VuLinh011218/Auto_Switch/Hardware/02_Schematic_PDF/Smart_Switch.pdf

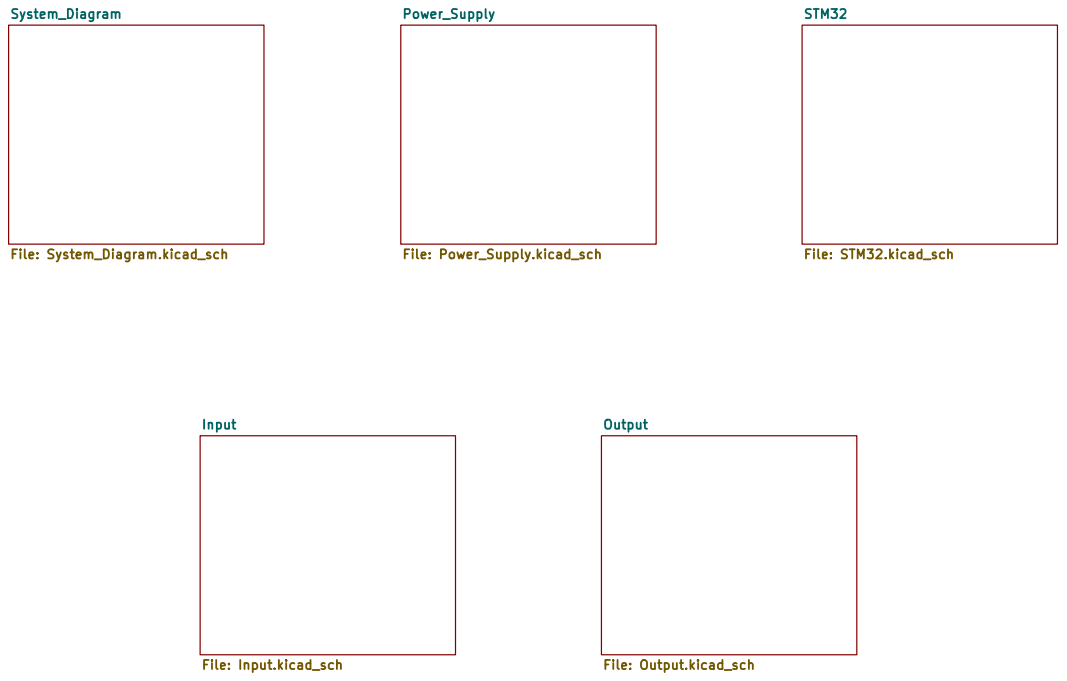
[picture p1: page 1]

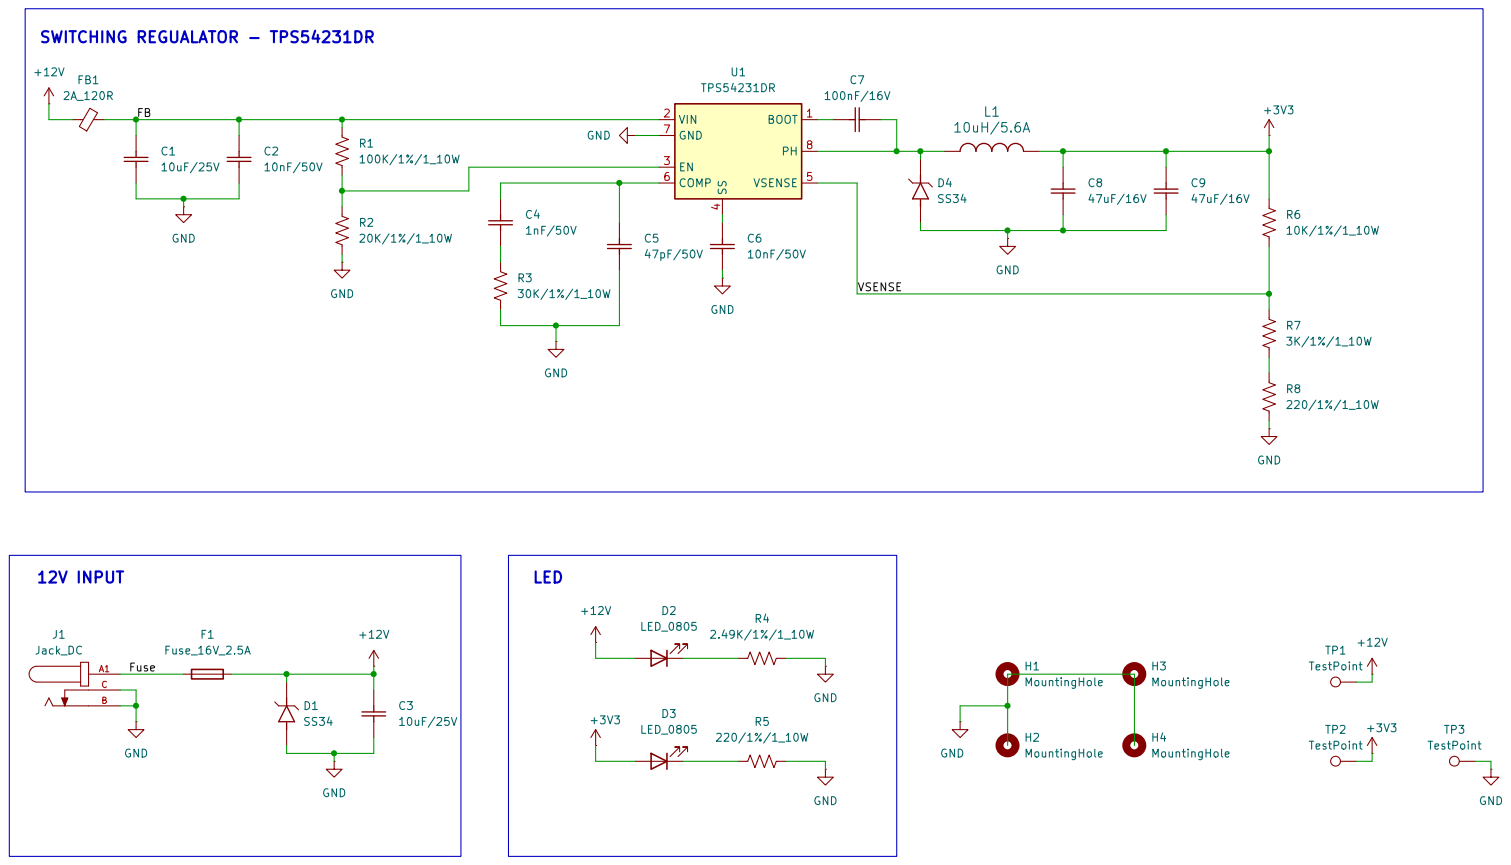
[picture p2: page 3]

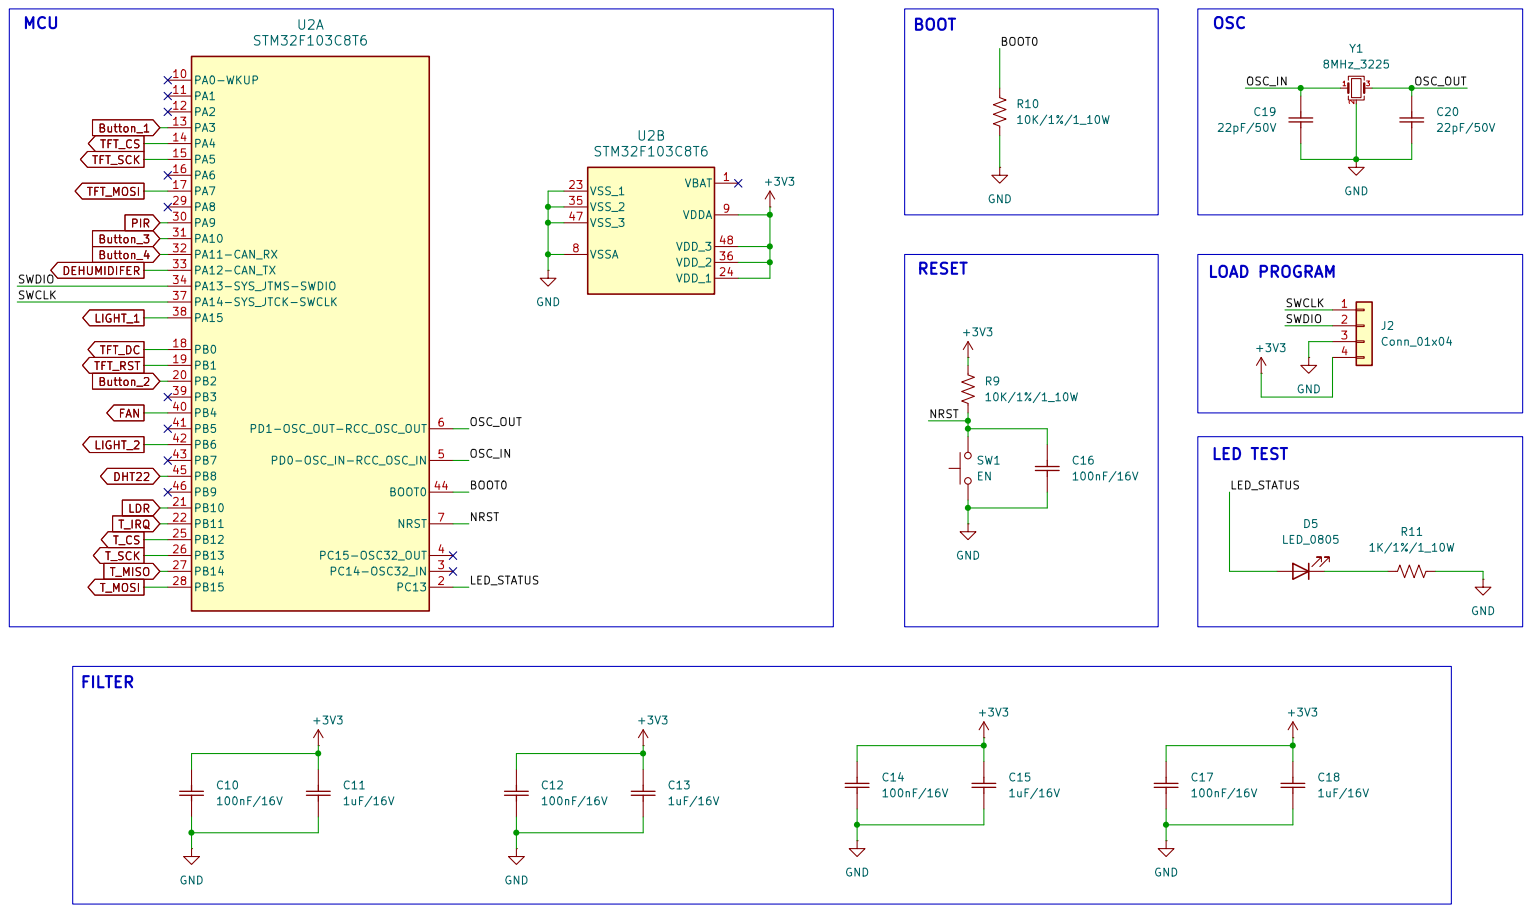
[picture p3: page 4]

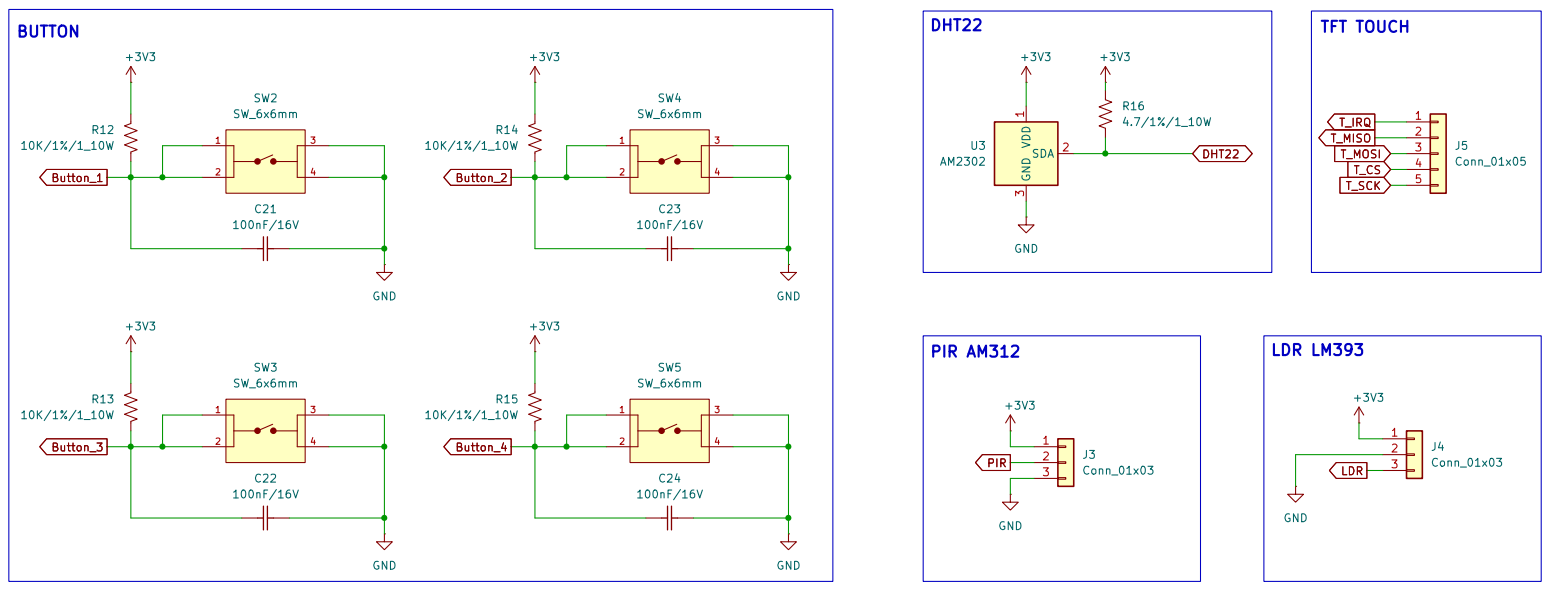
[picture p4: page 5]

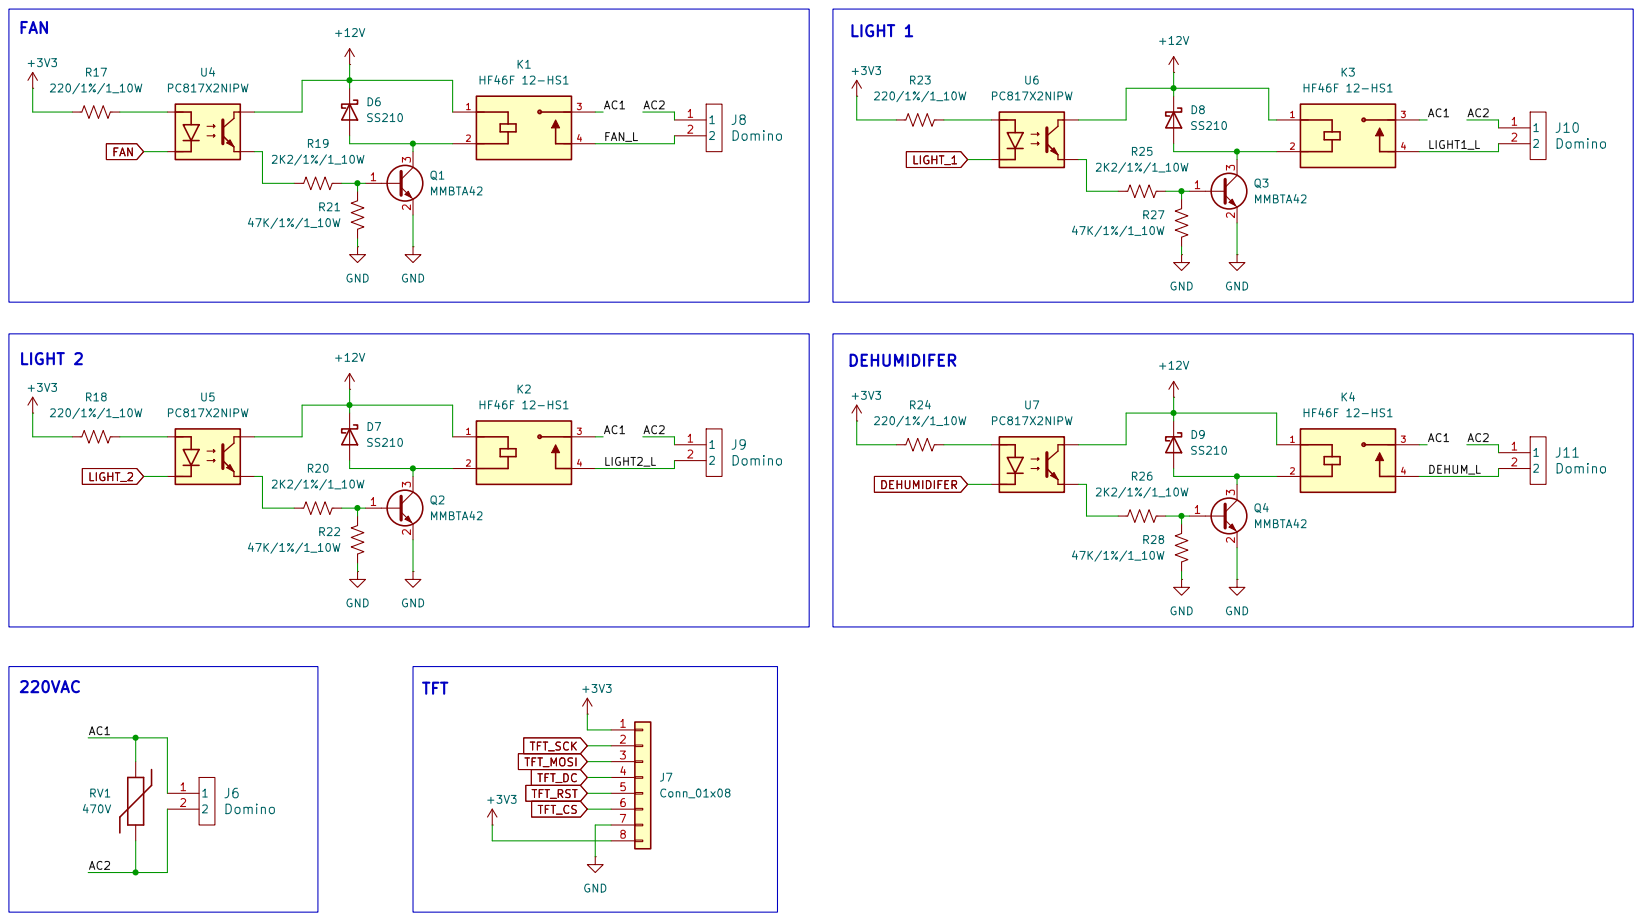
[picture p5: page 6]
