VuLinh011218/Auto_Switch/Hardware/01_Design/Smart_Switch.kicad_pcb

## KiCad design Hardware/01_Design/Smart_Switch.kicad_pcb (2026-11-08)

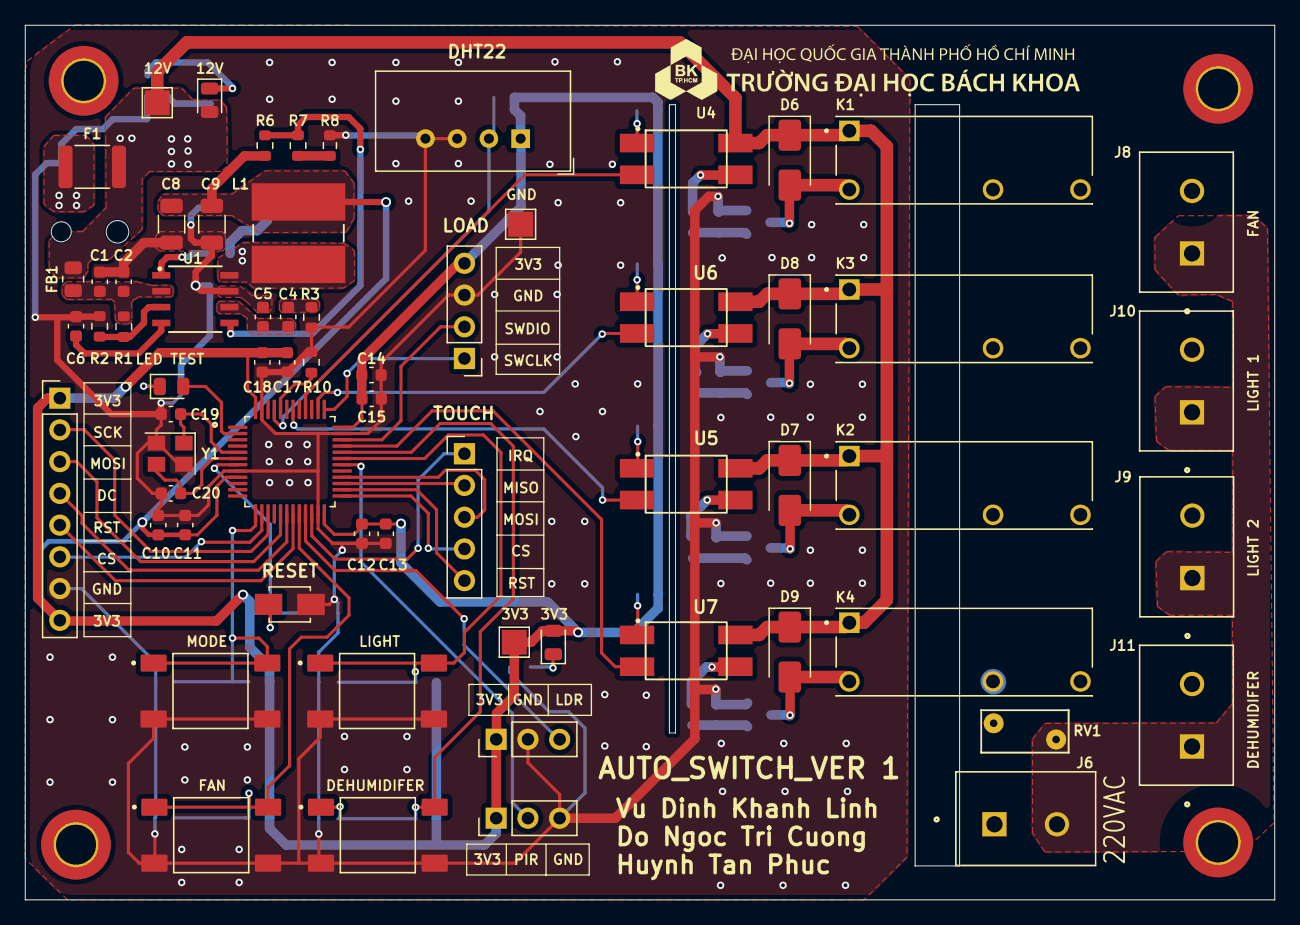
[picture p6: board Smart_Switch.kicad_pcb from above]

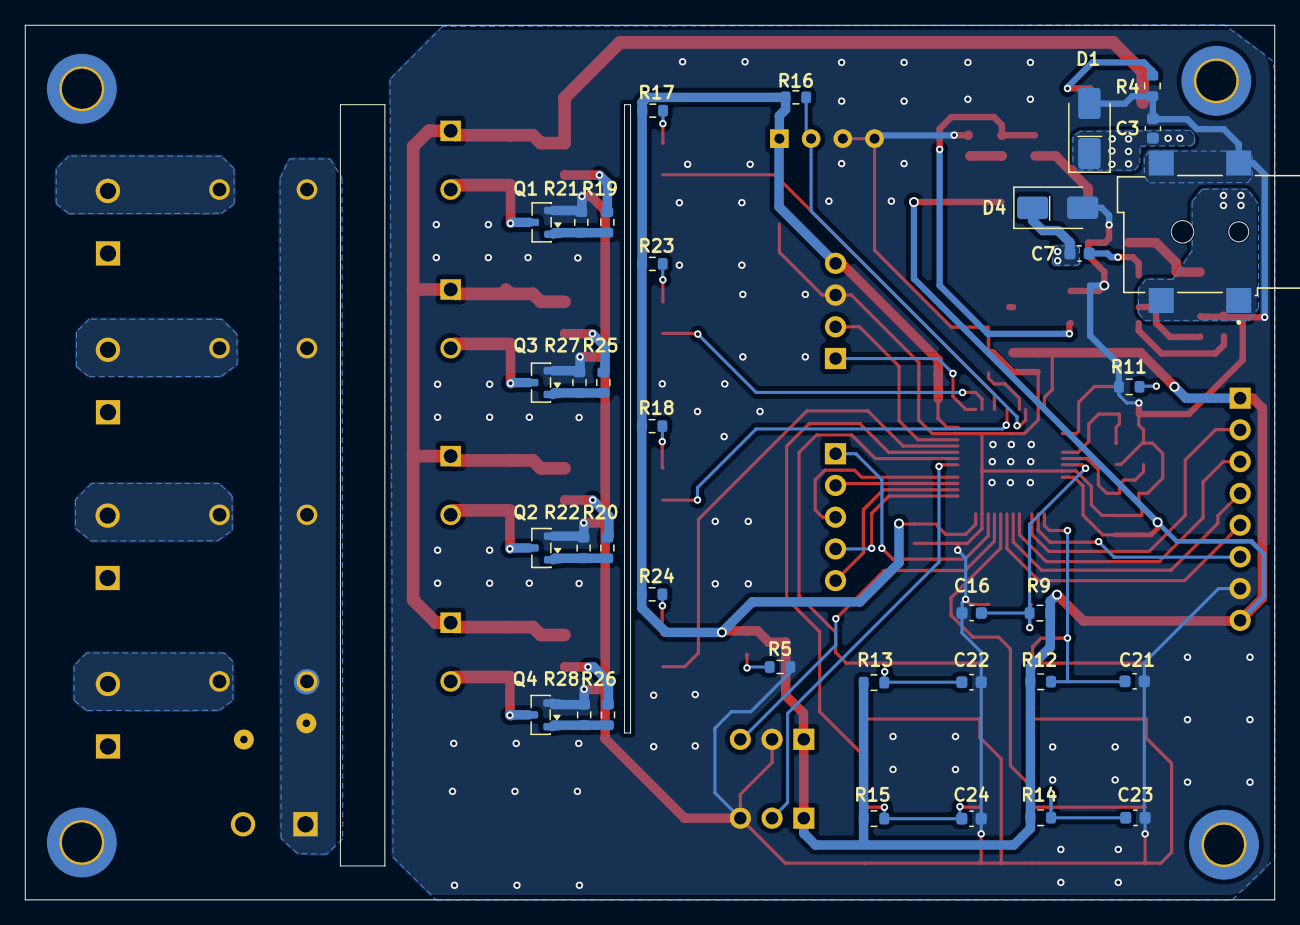
[picture p7: board Smart_Switch.kicad_pcb from below]

Board: 2 copper layers, 100.0 x 70.0 mm, 104 parts (35 on the bottom side), 66 nets.

Parts:
C1, C3: 10uF/25V; Ceramic_Cap_0603
C2, C6: 10nF/50V; Ceramic_Cap_0603
C4: 1nF/50V; Ceramic_Cap_0603
C5: 47pF/50V; Ceramic_Cap_0603
C7, C10, C12, C14, C16, C17, C21, C22, C23, C24: 100nF/16V; Ceramic_Cap_0603
C8, C9: 47uF/16V; Ceramic_Cap_1206
C11, C13, C15, C18: 1uF/16V; Ceramic_Cap_0603
C19, C20: 22pF/50V; Ceramic_Cap_0603
D1, D4: SS34; D_SMA
D2, D3, D5: LED_0805
D6, D7, D8, D9: SS210; D_SMA
F1: Fuse_16V_2.5A; Fuse_1812_4532Metric
FB1: 2A_120R; FB_0805
H1, H2, H3, H4: MountingHole; MountingHole_3.2mm_M3_DIN965_Pad_TopBottom
J1: Jack_DC; Jack-DC
J2: Conn_01x04; PinHeader_1x04_P2.54mm_Vertical
J3, J4: Conn_01x03; PinHeader_1x03_P2.54mm_Vertical
J5: Conn_01x05; PinHeader_1x05_P2.54mm_Vertical
J6, J8, J9, J10, J11: Domino; Domino_2P
J7: Conn_01x08; PinHeader_1x08_P2.54mm_Vertical
K1, K2, K3, K4: HF46F 12-HS1; RELAY_HF46F_005-HS1
L1: 10uH/5.6A; IND_CD75NP_SUM
Q1, Q2, Q3, Q4: MMBTA42; SOT-23
R1: 100K/1%/1_10W; Res_0603
R2: 20K/1%/1_10W; Res_0603
R3: 30K/1%/1_10W; Res_0603
R4: 2.49K/1%/1_10W; Res_0603
R5, R8, R17, R18, R23, R24: 220/1%/1_10W; Res_0603
R6, R9, R10, R12, R13, R14, R15: 10K/1%/1_10W; Res_0603
R7: 3K/1%/1_10W; Res_0603
R11: 1K/1%/1_10W; Res_0603
R16: 4.7/1%/1_10W; Res_0603
R19, R20, R25, R26: 2K2/1%/1_10W; Res_0603
R21, R22, R27, R28: 47K/1%/1_10W; Res_0603
RV1: 470V; RV_Disc_D7mm_W3.4mm_P5mm
SW1: EN; SW_SMD
SW2, SW3, SW4, SW5: SW_6x6mm; TE_FSM4JSMA
TP1, TP2, TP3: TestPoint; TestPoint_Pad_2.0x2.0mm
U1: TPS54231DR; SOIC-8
U2: STM32F103C8T6; QFP50P900X900X160-48N
U3: AM2302; ASAIR_AM2302_P2.54mm_Vertical
U4, U5, U6, U7: PC817X2NIPW
Y1: 8MHz_3225; Crystal_SMD_4PIN_3225

Connections:
+3V3: C8.2, C9.2, C10.2, C11.2, C12.2, C13.2, C14.2, C15.2, C17.2, C18.2, D3.2 (A), J2.4, J3.1, J4.1, J7.1, J7.8, L1.1, R6.2, R9.2, R12.1, R13.1, R14.1, R15.1, R16.2, R17.1, R18.1, R23.1, R24.1, TP2.1 (1_1), U2.9 (VDDA), U2.24 (VDD_1), U2.36 (VDD_2), U2.48 (VDD_3), U3.1 (VDD)
+12V: C3.2, D1.2 (K), D2.2 (A), D6.1 (K), D7.1 (K), D8.1 (K), D9.1 (K), F1.2, FB1.1, K1.1, K2.1, K3.1, K4.1, TP1.1 (1_1), U4.4 (C), U5.4 (C), U6.4 (C), U7.4 (C)
/Output/AC1: J6.1, K1.3, K2.3, K3.3, K4.3, RV1.2
/Output/AC2: J6.2, J8.1, J9.1, J10.1, J11.1, RV1.1
/Output/DEHUM_L: J11.2, K4.4
/Output/FAN_L: J8.2, K1.4
/Output/LIGHT1_L: J10.2, K3.4
/Output/LIGHT2_L: J9.2, K2.4
/Power_Supply/FB: C1.2, C2.2, FB1.2, R1.2, U1.2 (VIN)
/Power_Supply/Fuse: F1.1, J1.A1, J1.A2
/Power_Supply/VSENSE: R6.1, R7.2, U1.5 (VSENSE)
/STM32/BOOT0: R10.2, U2.44 (BOOT0)
/STM32/LED_STATUS: D5.2 (A), U2.2 (PC13)
/STM32/NRST: C16.2, R9.1, SW1.2, U2.7 (NRST)
/STM32/OSC_IN: C19.2, U2.5 (PD0-OSC_IN-RCC_OSC_IN), Y1.1
/STM32/OSC_OUT: C20.2, U2.6 (PD1-OSC_OUT-RCC_OSC_OUT), Y1.3
/STM32/SWCLK: J2.1, U2.37 (PA14-SYS_JTCK-SWCLK)
/STM32/SWDIO: J2.2, U2.34 (PA13-SYS_JTMS-SWDIO)
Button_1: C21.1, R12.2, SW2.1, SW2.2, U2.13 (PA3)
Button_2: C23.1, R14.2, SW4.1, SW4.2, U2.20 (PB2)
Button_3: C22.1, R13.2, SW3.1, SW3.2, U2.31 (PA10)
Button_4: C24.1, R15.2, SW5.1, SW5.2, U2.32 (PA11-CAN_RX)
DEHUMIDIFER: U2.33 (PA12-CAN_TX), U7.2 (K)
DHT22: R16.1, U2.45 (PB8), U3.2 (SDA)
FAN: U2.40 (PB4), U4.2 (K)
GND: C1.1, C2.1, C3.1, C5.1, C6.1, C8.1, C9.1, C10.1, C11.1, C12.1, C13.1, C14.1, C15.1, C16.1, C17.1, C18.1, C19.1, C20.1, C21.2, C22.2, C23.2, C24.2, D1.1 (A), D4.1 (A), J1.B, J1.C, J2.3, J3.3, J4.2, J7.7, Q1.2 (E), Q2.2 (E), Q3.2 (E), Q4.2 (E), R2.1, R3.1, R4.2, R5.2, R8.1, R10.1, R11.1, R21.1, R22.1, R27.1, R28.1, SW1.1, SW2.3, SW2.4, SW3.3, SW3.4, SW4.3, SW4.4, SW5.3, SW5.4, TP3.1 (1_1), U1.7 (GND), U2.8 (VSSA), U2.23 (VSS_1), U2.35 (VSS_2), U2.47 (VSS_3), U3.3 (GND), U3.4 (GND), Y1.2 (G), Y1.4 (G)
LDR: J4.3, U2.21 (PB10)
LIGHT_1: U2.38 (PA15), U6.2 (K)
LIGHT_2: U2.42 (PB6), U5.2 (K)
unnamed: C4.1, R3.2
unnamed: D2.1 (K), R4.1
unnamed: D3.1 (K), R5.1
unnamed: C7.1, D4.2 (K), L1.2, U1.8 (PH)
unnamed: D5.1 (K), R11.2
unnamed: D6.2 (A), K1.2, Q1.3 (C)
unnamed: D7.2 (A), K2.2, Q2.3 (C)
unnamed: D8.2 (A), K3.2, Q3.3 (C)
unnamed: D9.2 (A), K4.2, Q4.3 (C)
unnamed: Q1.1 (B), R19.2, R21.2
unnamed: Q2.1 (B), R20.2, R22.2
unnamed: Q3.1 (B), R25.2, R27.2
unnamed: Q4.1 (B), R26.2, R28.2
unnamed: R7.1, R8.2
unnamed: C7.2, U1.1 (BOOT)
unnamed: C4.2, C5.2, U1.6 (COMP)
unnamed: R1.1, R2.2, U1.3 (EN)
unnamed: C6.2, U1.4 (SS)
unnamed: R17.2, U4.1 (A)
unnamed: R19.1, U4.3 (E)
unnamed: R18.2, U5.1 (A)
unnamed: R20.1, U5.3 (E)
unnamed: R23.2, U6.1 (A)
unnamed: R25.1, U6.3 (E)
unnamed: R24.2, U7.1 (A)
unnamed: R26.1, U7.3 (E)
PIR: J3.2, U2.30 (PA9)
TFT_CS: J7.6, U2.14 (PA4)
TFT_DC: J7.4, U2.18 (PB0)
TFT_MOSI: J7.3, U2.17 (PA7)
TFT_RST: J7.5, U2.19 (PB1)
TFT_SCK: J7.2, U2.15 (PA5)
T_CS: J5.4, U2.25 (PB12)
T_IRQ: J5.1, U2.22 (PB11)
T_MISO: J5.2, U2.27 (PB14)
T_MOSI: J5.3, U2.28 (PB15)
T_SCK: J5.5, U2.26 (PB13)
