VuLinh011218/Auto_Switch/(commit log)

2026-09-29 Placement component
    [Input.kicad_sch, Output.kicad_sch, STM32.kicad_sch, Smart_Switch.csv, Smart_Switch.kicad_pcb, Smart_Switch_BOM.xlsx]
2026-11-08 Update hardware design and Gerber files
